neurohazardous/hyperSynch/assets/diagram.pptx

To AB USB

TRS Female

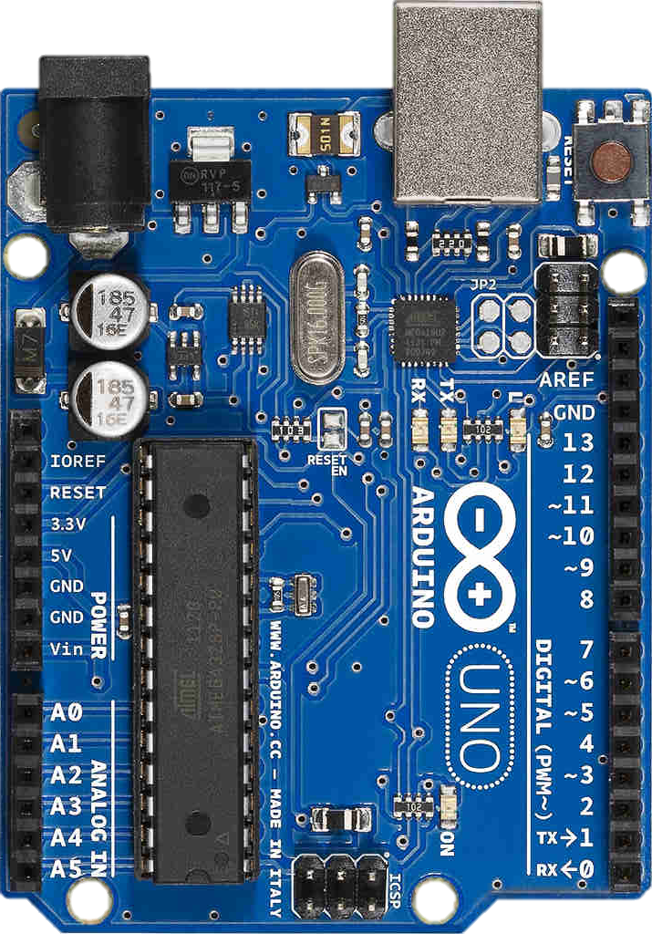
[picture p16: figure]
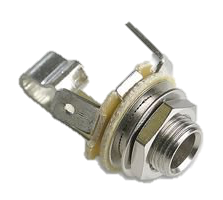
[picture p17: figure]

From button

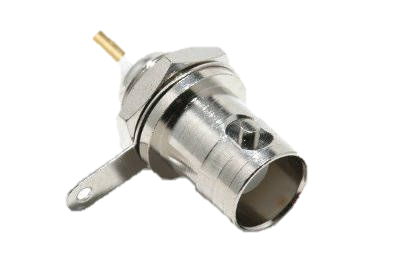
[picture p18: figure]

BNC Female

TTL to audio & video

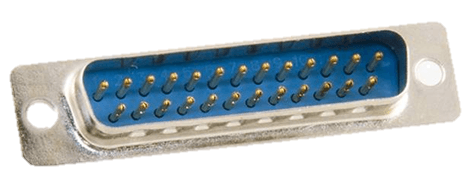
[picture p19: figure]

DB25 Female

TTL to EEG 1

DB25 Female

TTL to EEG 2

TTL Output

Terminal strip

Ground

Input from button
