neurohazardous/hyperSynch/assets/12.JPG

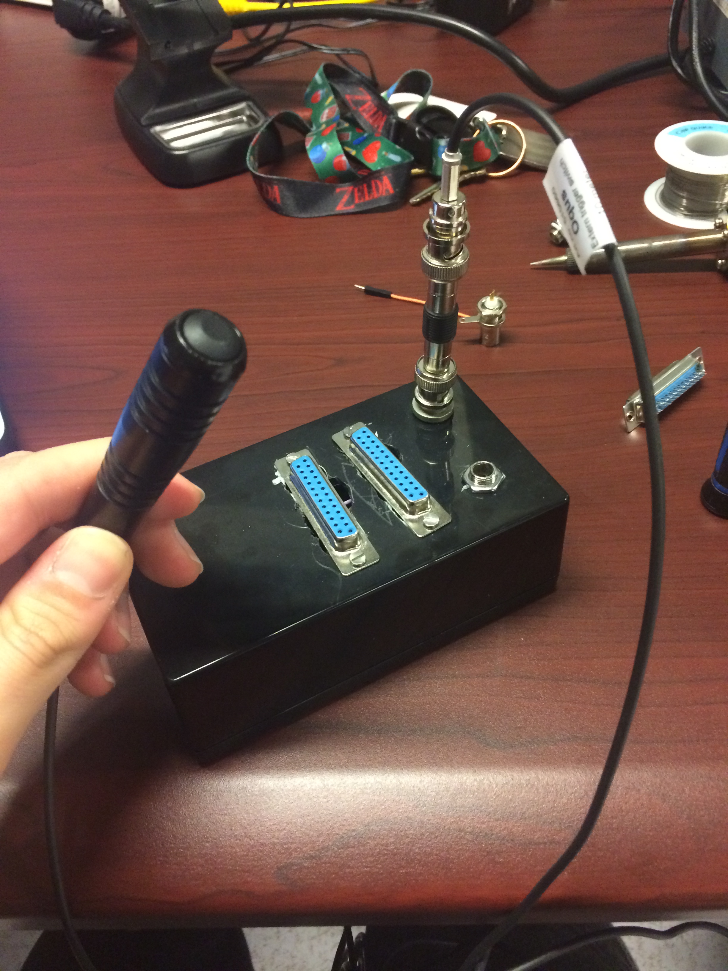
assets/12.JPG
